gaggi/27c160-tl866-adapter/README.md

# 27c160-tl866-adapter
Adapter to Program 27c160, 27c322, 27c400 and 27c800 EPROM´s on the popular TL866 Universal Programmer from Autoelectric.
