gaggi/27c160-tl866-adapter/eagle/27C160_Adapter.brd

## EAGLE design eagle/27C160_Adapter.brd (2016-08-09)

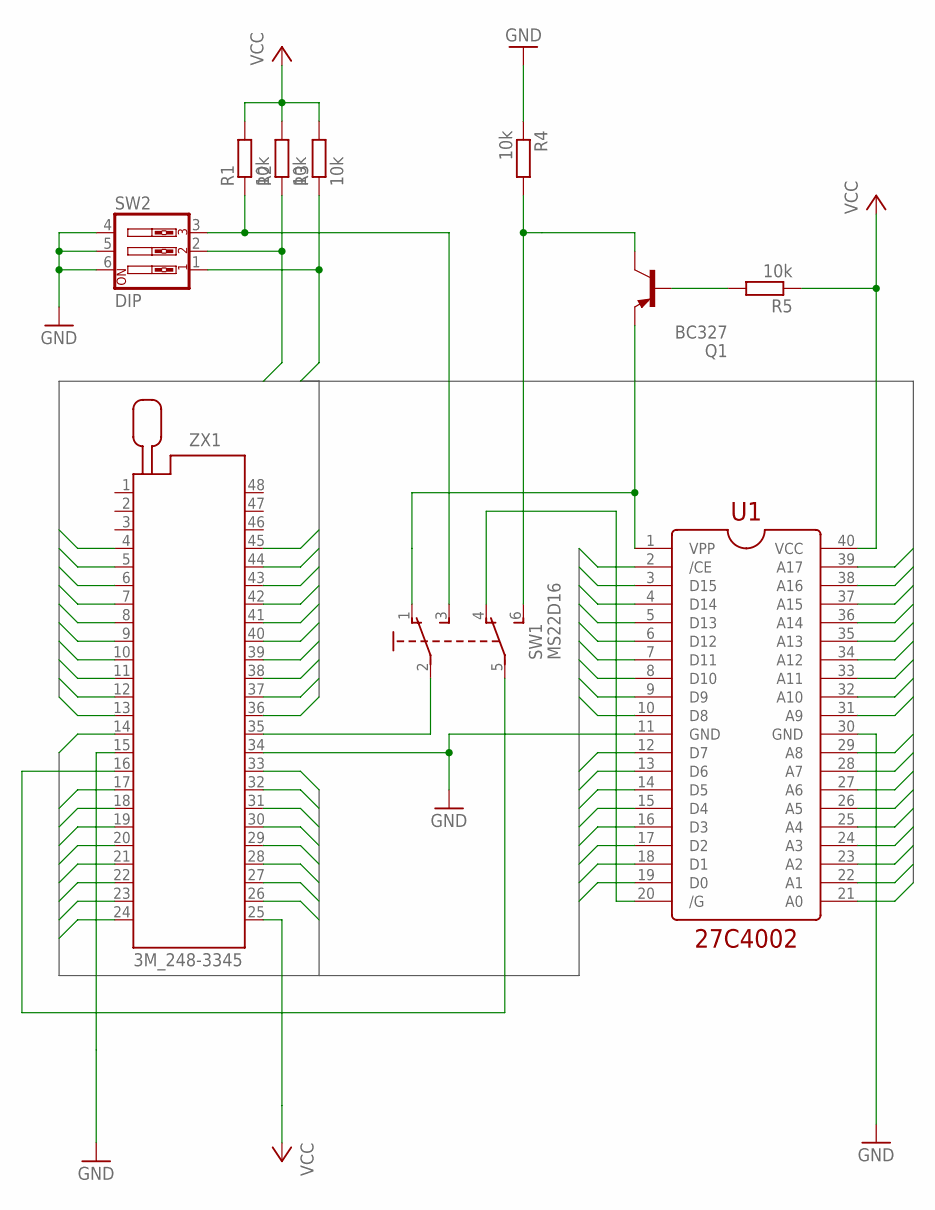
[picture p2: schematic 27C160_Adapter.sch]

Parts:
Q1: BC327; TO92-EBC
R1, R2, R3, R4, R5: 10k; 0207/10
SW1: MS22D16
SW2: DIP; EDG-03
U1: 27C4002
ZX1: 3M_248-3345

Connections:
A0: U1.21 (A0), ZX1.13
A1: U1.22 (A1), ZX1.12
A2: U1.23 (A2), ZX1.11
A3: U1.24 (A3), ZX1.10
A4: U1.25 (A4), ZX1.9
A5: U1.26 (A5), ZX1.8
A6: U1.27 (A6), ZX1.7
A7: U1.28 (A7), ZX1.6
A8: U1.29 (A8), ZX1.44
A9: U1.31 (A9), ZX1.43
A10: U1.32 (A10), ZX1.42
A11: U1.33 (A11), ZX1.41
A12: U1.34 (A12), ZX1.40
A13: U1.35 (A13), ZX1.39
A14: U1.36 (A14), ZX1.38
A15: U1.37 (A15), ZX1.37
A16: U1.38 (A16), ZX1.36
A17: U1.39 (A17), ZX1.5
A18: R3.1, SW2.1, ZX1.4
A19: R2.1, SW2.2, ZX1.45
A20: R1.1, SW1.3 (S), SW2.3
D0: U1.19 (D0), ZX1.17
D1: U1.18 (D1), ZX1.19
D2: U1.17 (D2), ZX1.21
D3: U1.16 (D3), ZX1.23
D4: U1.15 (D4), ZX1.26
D5: U1.14 (D5), ZX1.28
D6: U1.13 (D6), ZX1.30
D7: U1.12 (D7), ZX1.32
D8: U1.10 (D8), ZX1.18
D9: U1.9 (D9), ZX1.20
D10: U1.8 (D10), ZX1.22
D11: U1.7 (D11), ZX1.24
D12: U1.6 (D12), ZX1.27
D13: U1.5 (D13), ZX1.29
D14: U1.4 (D14), ZX1.31
D15: U1.3 (D15), ZX1.33
E: U1.2 (/CE), ZX1.14
GND: R4.1, SW2.4, SW2.5, SW2.6, U1.11 (GND), U1.30 (GND), ZX1.15, ZX1.34
unnamed: Q1.B, R5.2
unnamed: SW1.2, ZX1.35
unnamed: Q1.C, R4.2, SW1.6 (S1)
unnamed: SW1.4 (O1), U1.20 (/G)
unnamed: SW1.5 (P1), ZX1.16
VCC: R1.2, R2.2, R3.2, R5.1, U1.40 (VCC), ZX1.25
VPP: Q1.E, SW1.1 (O), U1.1 (VPP)

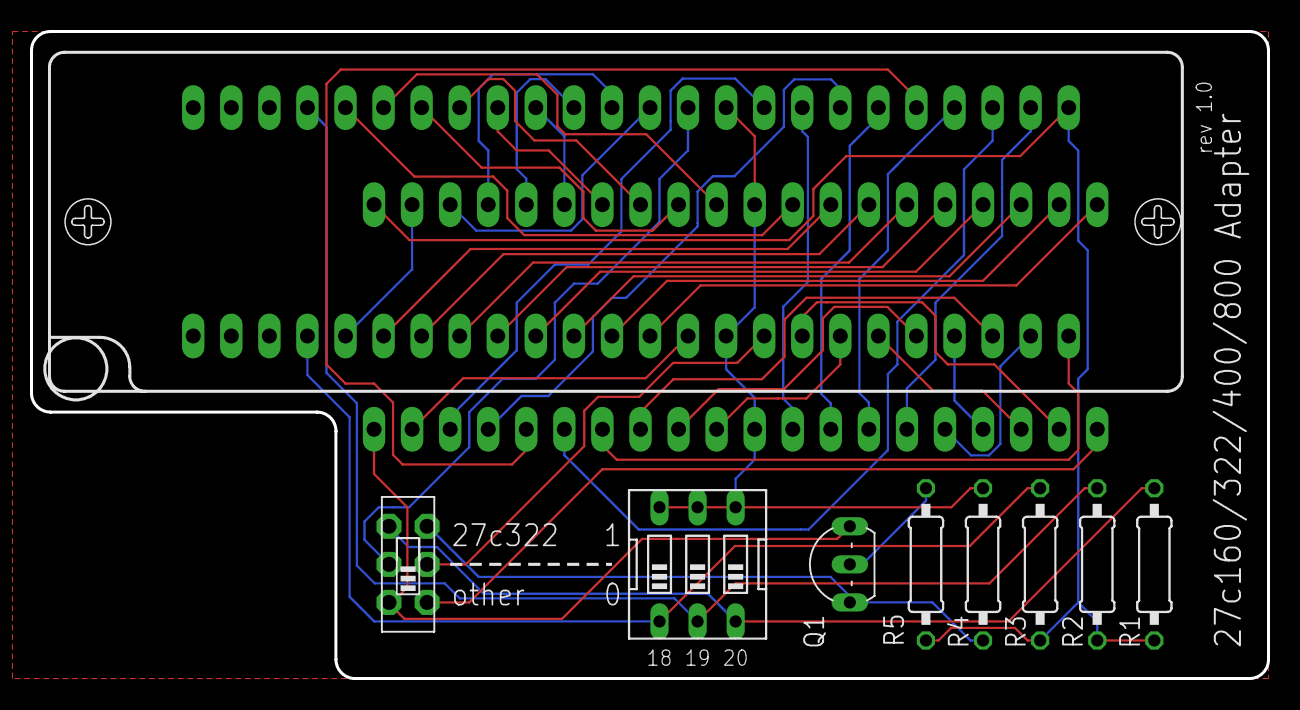
[picture p3: board 27C160_Adapter.brd from above]

Board: 2 copper layers, 82.5 x 43.2 mm, 10 parts (0 on the bottom side), 46 nets.
