gaggi/27c160-tl866-adapter/(commit log)

2016-08-09 Initial Release
    [27C160_Adapter.GBL, 27C160_Adapter.GBO, 27C160_Adapter.GBP, 27C160_Adapter.GBS, 27C160_Adapter.GTL, 27C160_Adapter.GTO, 27C160_Adapter.GTP, 27C160_Adapter.GTS]
2017-07-28 Converting from Eagle to KiCad
    Done the converting and created a 2x1 Panel for use with the chinese 10x10cm PCB services.
    [27C160_Adapter-panel-B.Mask.gbr, 27C160_Adapter-panel-B.SilkS.gbr, 27C160_Adapter-panel-Bottom.gbr, 27C160_Adapter-panel-Edge.Cuts.gbr, 27C160_Adapter-panel-F.Mask.gbr, 27C160_Adapter-panel-F.SilkS.gbr, 27C160_Adapter-panel-Top.gbr, 27C160_Adapter-panel.drl]
